SQ9MDD/arduino_tnc/atncPlus-lista-czesci.txt

--------------------------------------------------------------
Arduino TNC plus lista części
--------------------------------------------------------------
Rezystory:
100k			1
33k			1
15k			1
12k			1
10k			7
8k2			1
3k9			1
2k2			2
1k0			3
680			1
470			3
220			1
47k			1

Kondensatory:
100nF			9
33pF			2
100uF			1

Tranzystory:
BC547			1
BC560			1

Pozostałe:
TCM3105			1
Kwarc 4,43MHz		1
4N255			1
dioda 1N4148		2
Critchley 9000		2	(transformator separujący)
Zaciski śrubowe x2	3	
goldpin żeński listwa	1
goldpin męski listwa	1
arduino nano		1
PCB			1
--------------------------------------------------------------
