SQ9MDD/arduino_tnc/arduino-tnc.JPG

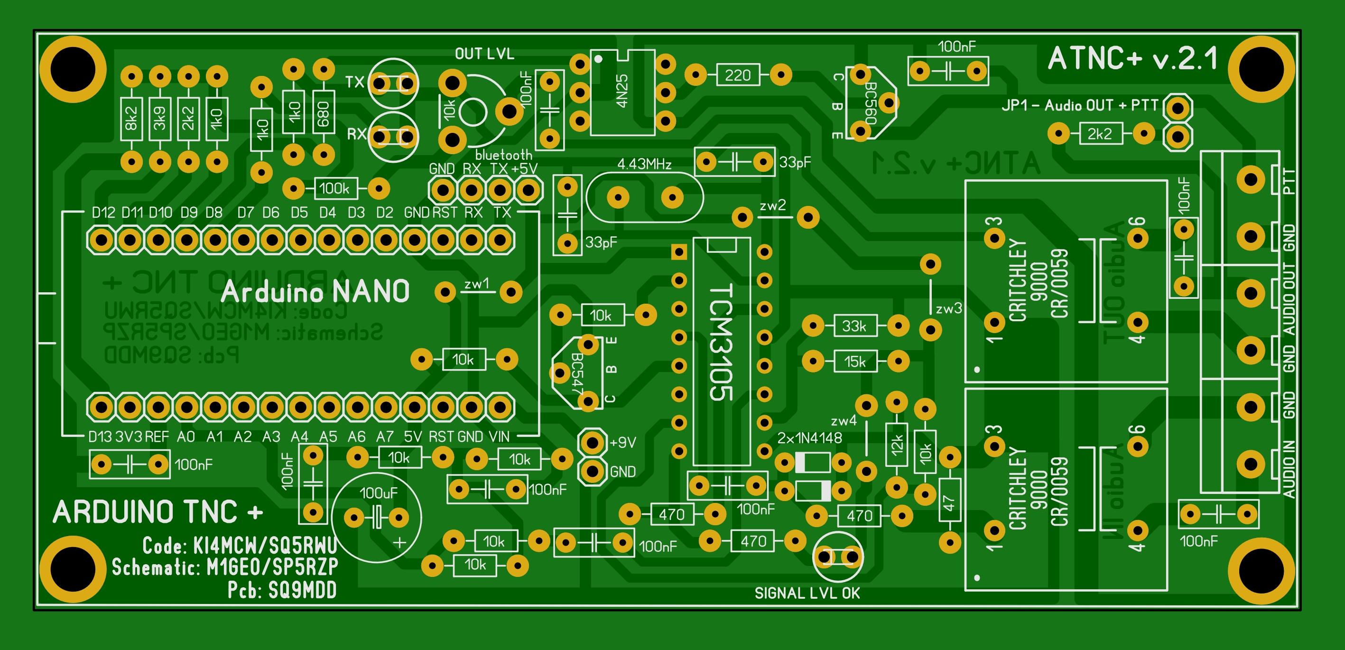
arduino-tnc.JPG
