SQ9MDD/arduino_tnc/TCM3105MiniDigi.png

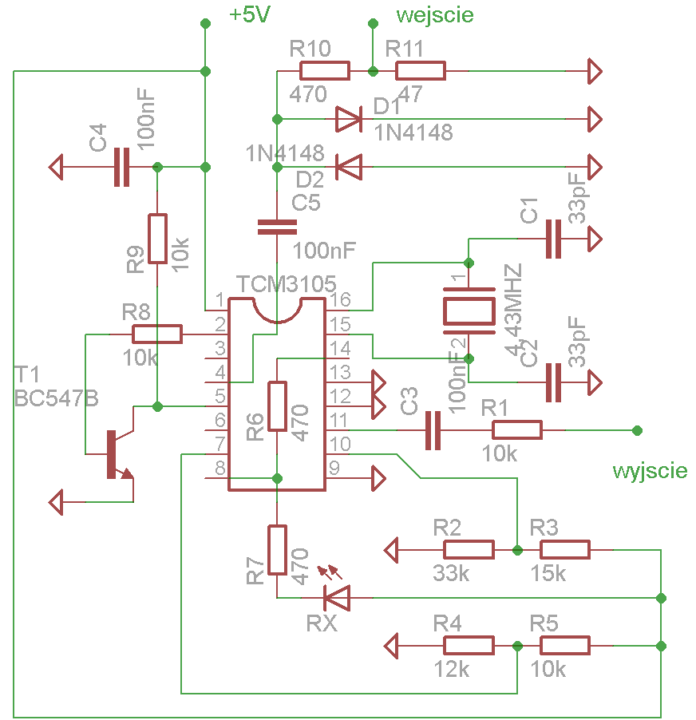
TCM3105MiniDigi.png
