SQ9MDD/arduino_tnc/pcb-pint.pdf

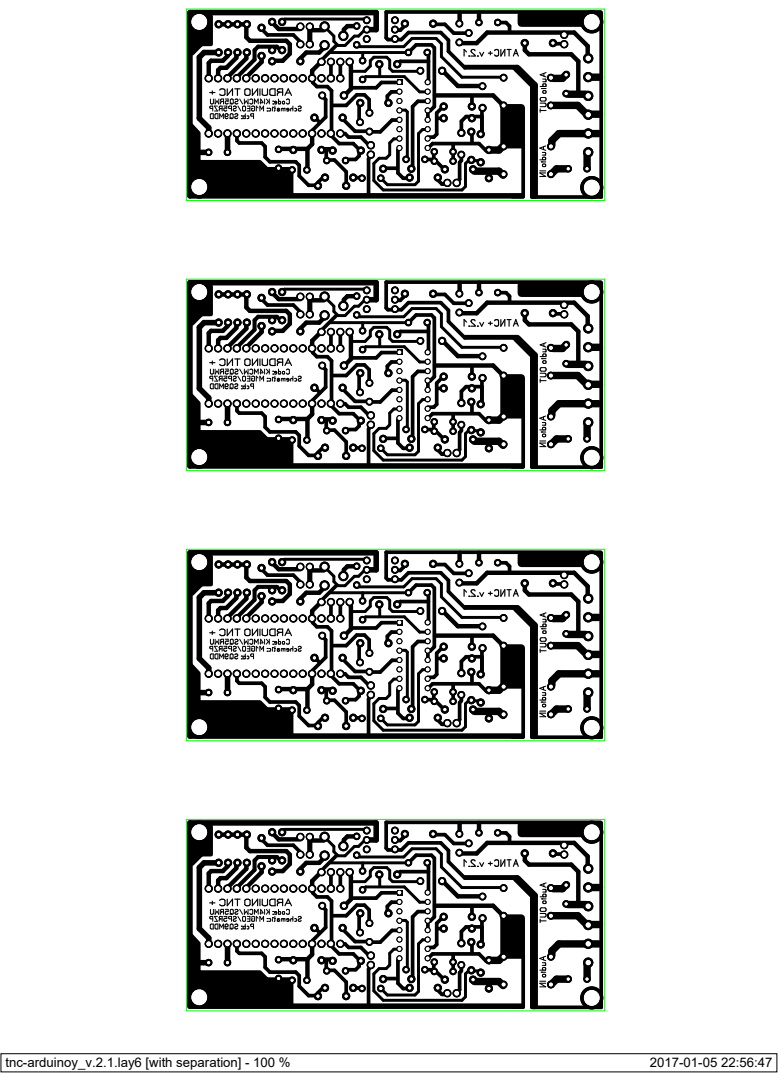
[picture p3: page 1]
tnc-arduinoy_v.2.1.lay6 [with separation] - 100 %
