SQ9MDD/arduino_tnc/(list of files, drawings)

Other design files:
tnc-arduinoy_v.2.1.lay6
