SQ9MDD/arduino_tnc/(commit log)

2017-01-05 ostateczna wersja PCB
2017-01-08 v.0.15.4 STABLE
    Testing with TCM3105 with new hardware PCB: THIS IS LATEST STABLE
    RELEASE!
